sdp8483/timed_off/pcb/images/modBoot_bottom.jpg

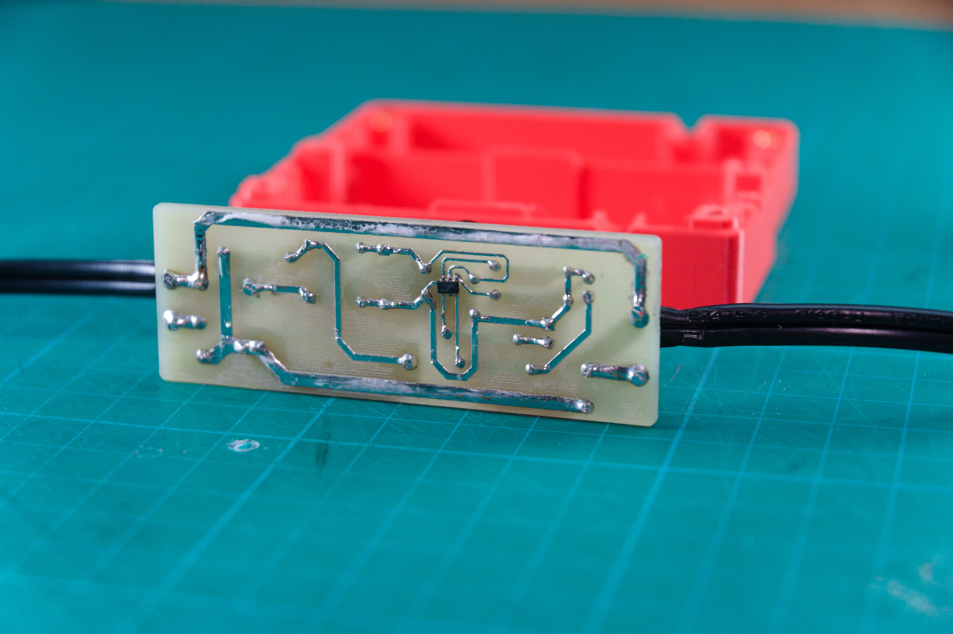
pcb/images/modBoot_bottom.jpg
