sdp8483/timed_off/pcb/images/modBoot_side.jpg

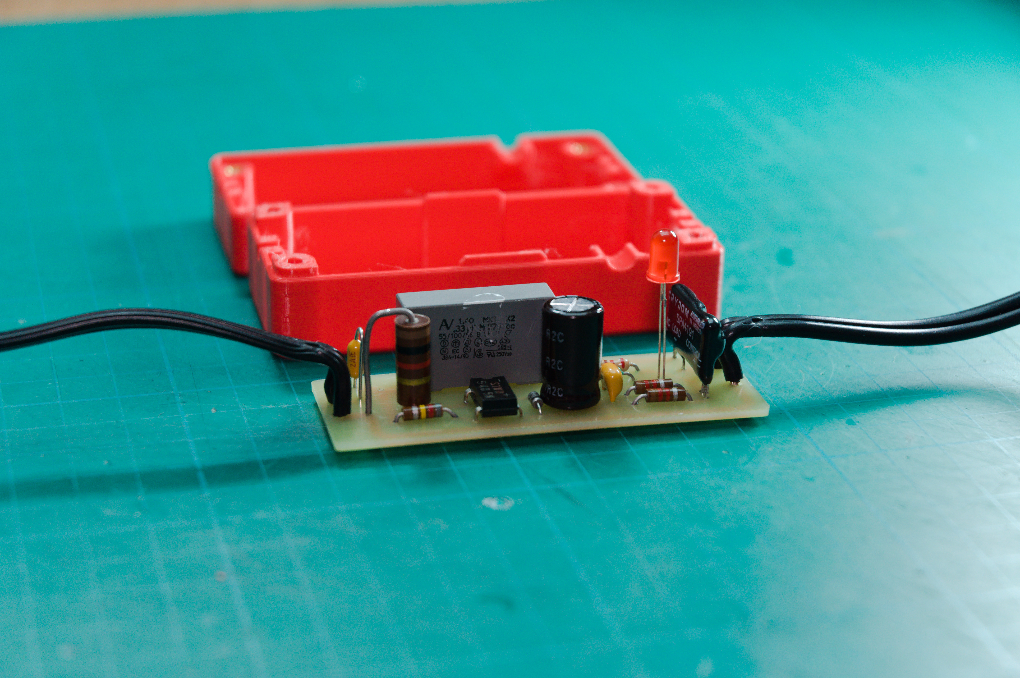
pcb/images/modBoot_side.jpg
