sdp8483/timed_off/README.md

# Auto Off Circuit for Low Power AC Devices
For more info: https://samueldperry.com/2021/07/25/modifying-a-boot-dryer/
