sdp8483/timed_off/pcb/images/modBoot_sch.png

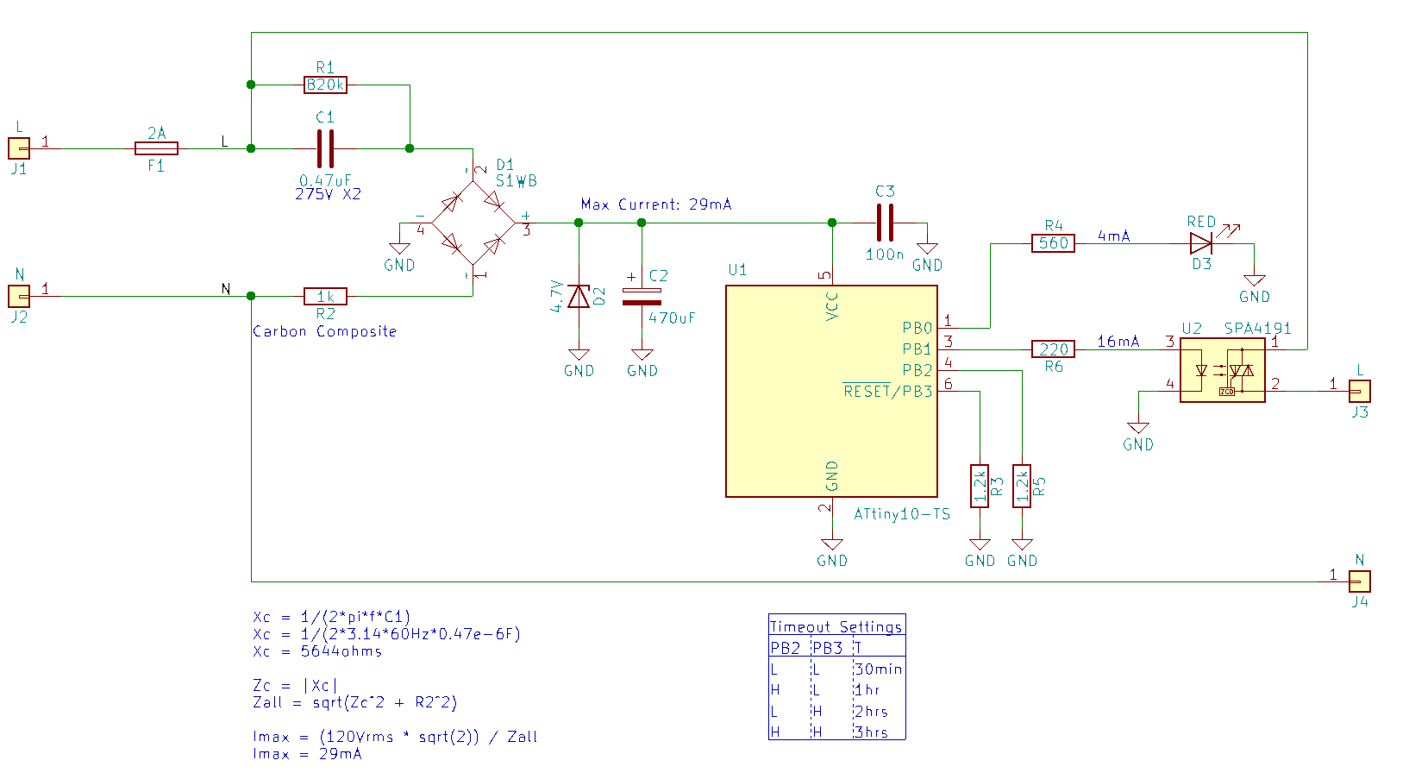
pcb/images/modBoot_sch.png
