sdp8483/timed_off/enclosure/top_2.8mmx5.7mm_cord_grip.amf

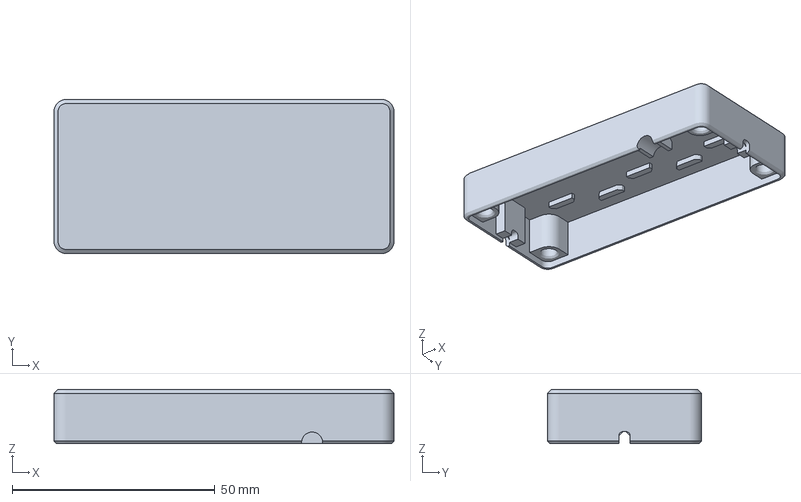
[picture p4: CAD file, 2021-07-25]
enclosure/top_2.8mmx5.7mm_cord_grip.amf
83.9 x 38.0 x 13.4 mm
