sdp8483/timed_off/enclosure/bottom_2.8mmx5.7mm_cord_grip.amf

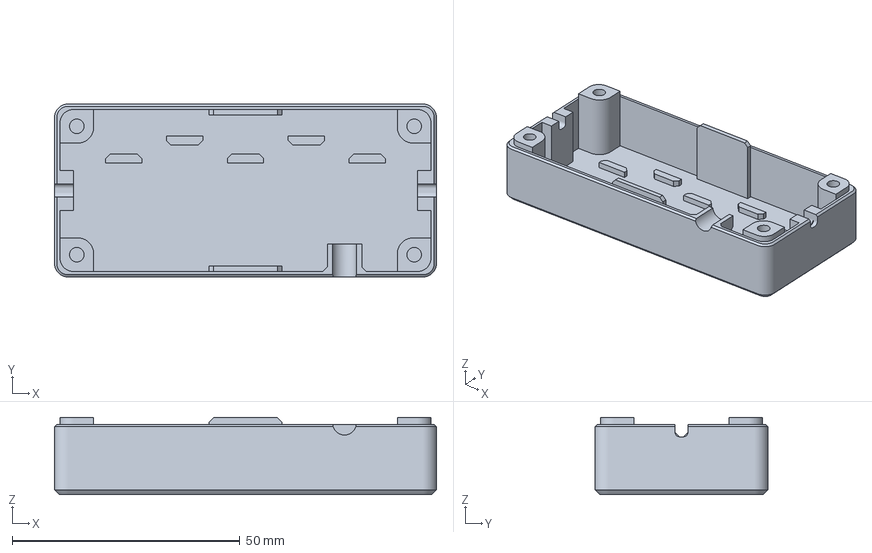
[picture p5: CAD file, 2021-07-25]
enclosure/bottom_2.8mmx5.7mm_cord_grip.amf
83.9 x 38.0 x 16.9 mm
