sdp8483/timed_off/enclosure/timed_off.FCStd

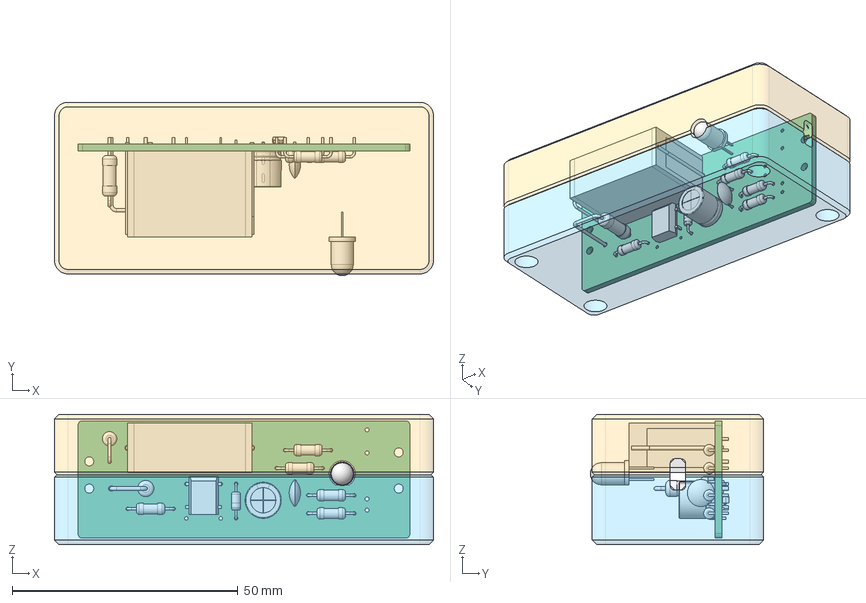
[picture p6: CAD file, 2021-07-18]
enclosure/timed_off.FCStd
83.9 x 38.4 x 28.8 mm
Pcb_8d35
REF_C_Rect_L240mm_W86mm_P2250mm_MKT_60F06FD8
D1_Diode_Bridge_DIP-4_W7.62mm_P5.08mm_60EDDCCC
R6_R_Axial_DIN0207_L63mm_D25mm_P1016mm_Horizontal_60EDDDAE x 5
R2_R_Axial_DIN0411_L99mm_D36mm_P762mm_Vertical_60EDDD52
F1_R_Axial_DIN0309_L90mm_D32mm_P508mm_Vertical_60EDDD0C
D3_LED_D5.0mm_60EDDCFD
D2_D_DO-35_SOD27_P7.62mm_Horizontal_60EDDCEB
C3_C_Disc_D60mm_W25mm_P500mm_60EED77B
C2_CP_Radial_D80mm_P380mm_60EDDC9F
C1_C_Rect_L290mm_W110mm_P2750mm_MKT_60EDDBF6
U1_SOT_23_6_60EDDDC4
bottom
top
