sdp8483/timed_off/(list of files, cad)

Other CAD files:
enclosure/timed_off-enclosuretop.amf
enclosure/timed_off-enclosurebottom.amf
