sdp8483/timed_off/pcb/timed_off.kicad_pcb

## KiCad design pcb/timed_off.kicad_pcb (2021-07-15)

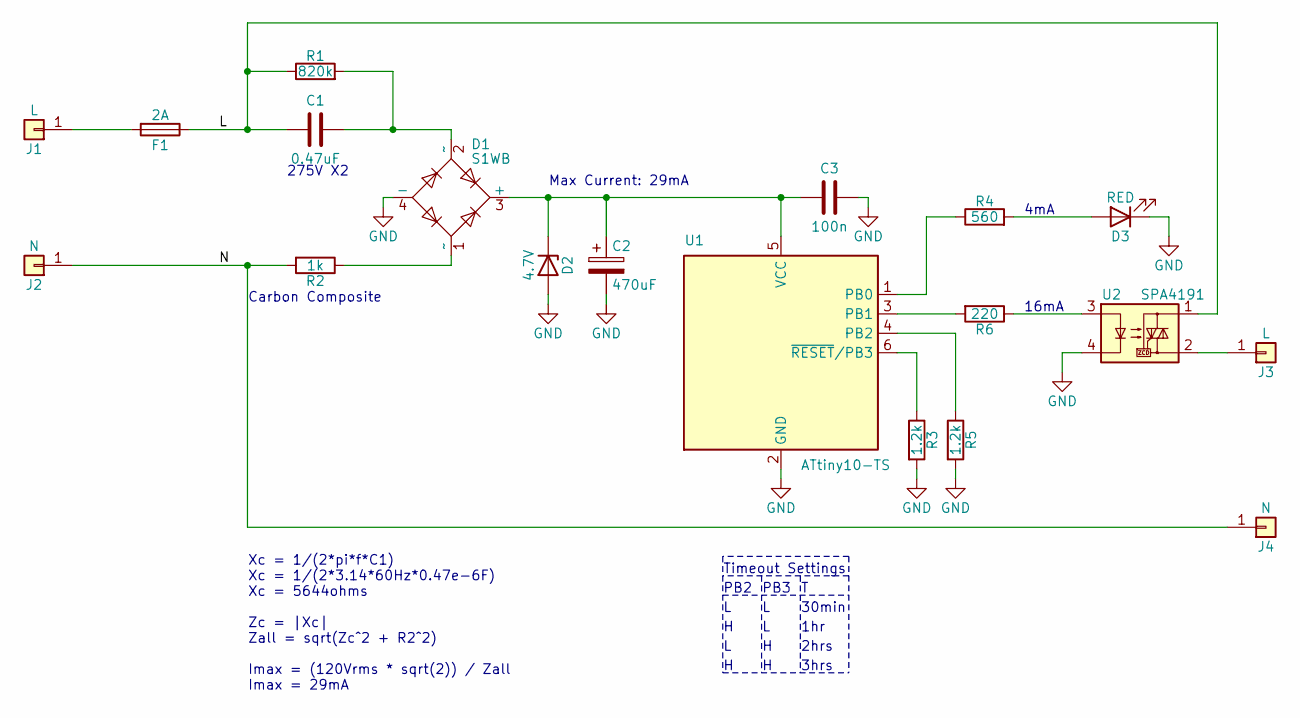
[picture p7: schematic timed_off.sch, Timmed Off]

Parts:
C1: 0.47uF; C_Rect_L29.0mm_W11.0mm_P27.50mm_MKT
C2: 470uF; CP_Radial_D8.0mm_P3.80mm
C3: 100n; C_Disc_D6.0mm_W2.5mm_P5.00mm
D1: S1WB
D2: 4.7V; D_DO-35_SOD27_P7.62mm_Horizontal
D3: RED; LED_D5.0mm
F1: 2A; R_Axial_DIN0309_L9.0mm_D3.2mm_P5.08mm_Vertical
J1, J3: L; TestPoint_Plated_Hole_D2.0mm
J2, J4: N; TestPoint_Plated_Hole_D2.0mm
R1: 820k; R_Axial_DIN0207_L6.3mm_D2.5mm_P10.16mm_Horizontal
R2: 1k; R_Axial_DIN0411_L9.9mm_D3.6mm_P7.62mm_Vertical
R3, R5: 1.2k; R_Axial_DIN0207_L6.3mm_D2.5mm_P10.16mm_Horizontal
R4: 560; R_Axial_DIN0207_L6.3mm_D2.5mm_P10.16mm_Horizontal
R6: 220; R_Axial_DIN0207_L6.3mm_D2.5mm_P10.16mm_Horizontal
U1: ATtiny10-TS; SOT-23-6
U2: SPA4191

Connections:
/L: C1.2, F1.1, R1.1, U2.1
/N: J2.1, J4.1, R2.2
GND: C2.2, C3.1, D1.4 (-), D2.2 (A), D3.1 (K), R3.2, R5.2, U1.2 (GND), U2.4
unnamed: C1.1, D1.2 (~~), R1.2
unnamed: C2.1, C3.2, D1.3 (+), D2.1 (K), U1.5 (VCC)
unnamed: D1.1 (~~), R2.1
unnamed: D3.2 (A), R4.2
unnamed: F1.2, J1.1
unnamed: J3.1, U2.2
unnamed: R3.1, U1.6 (~RESET~/PB3)
unnamed: R4.1, U1.1 (PB0)
unnamed: R5.1, U1.4 (PB2)
unnamed: R6.1, U2.3
unnamed: R6.2, U1.3 (PB1)

Notes on the sheet:
16mA
PB2
PB3
30min
1hr
2hrs
3hrs
Timeout Settings
275V X2
Carbon Composite
Max Current: 29mA
Xc = 1/(2*pi*f*C1) Xc = 1/(2*3.14*60Hz*0.47e-6F) Xc = 5644ohms Zc = |Xc| Zall = sqrt(Zc^2 + R2^2) Imax = (120Vrms * sqrt(2)) / Zall Imax = 29mA
4mA

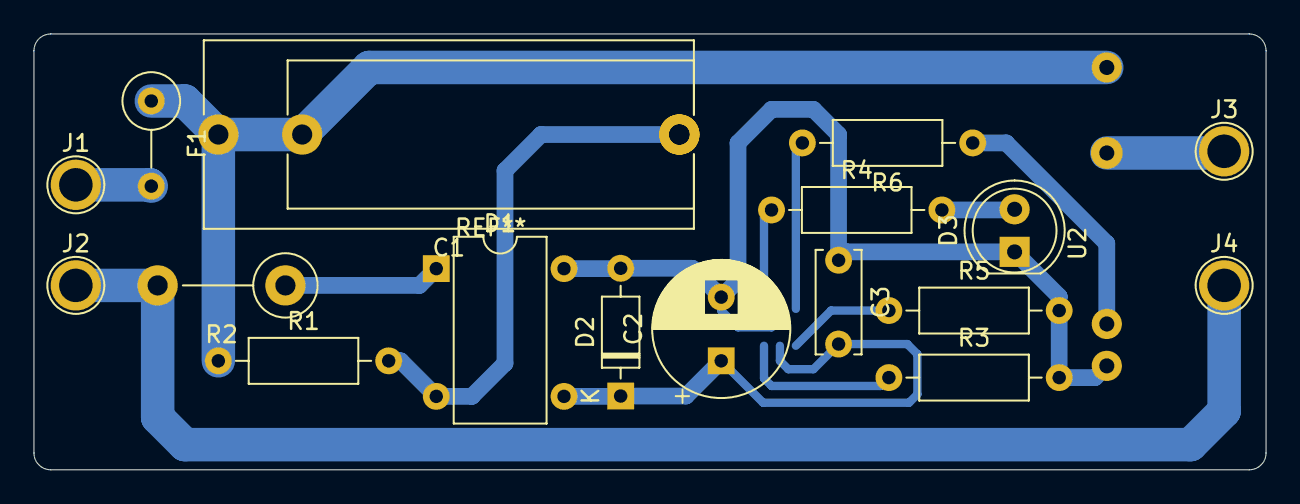
[picture p8: board timed_off.kicad_pcb from above]

Board: 2 copper layers, 73.5 x 26.0 mm, 19 parts (1 on the bottom side), 14 nets.
