sdp8483/timed_off/(commit log)

2021-07-13 init commit
    [timed_off.kicad_pcb, timed_off.sch]
2021-07-13 add timer0 init code and start dev
2021-07-13 add footprints
    [timed_off.sch]
2021-07-15 fix bridge footprint, add second dropper cap footprint
    [timed_off.kicad_pcb, timed_off.sch]
2021-07-15 create gcode
    [timed_off-B_Cu.gbr, timed_off-Edge_Cuts.gbr, timed_off-job.gbrjob, timed_off.drl]
2021-07-17 increase insert hole size, fix cord orientation
    [timed_off.FCStd]
2021-07-18 more cord grip
    [timed_off.FCStd]
2021-07-25 export for 3d printing
    [bottom_2.8mmx5.7mm_cord_grip.amf, top_2.8mmx5.7mm_cord_grip.amf]
2021-07-25 assembled pcb images
